fmfi-svt-deadlock/reader-hw/README.md

# PROJECT MOVED

This repository is now hosted here: https://gitlab.com/project-deadlock/reader/rdr-hw-fluocerite-model0

# reader-hw
Schematic, PCB layout and box for the Reader
