fmfi-svt-deadlock/reader-hw/deadlock-reader.brd

## EAGLE design deadlock-reader.brd (2015-10-26)

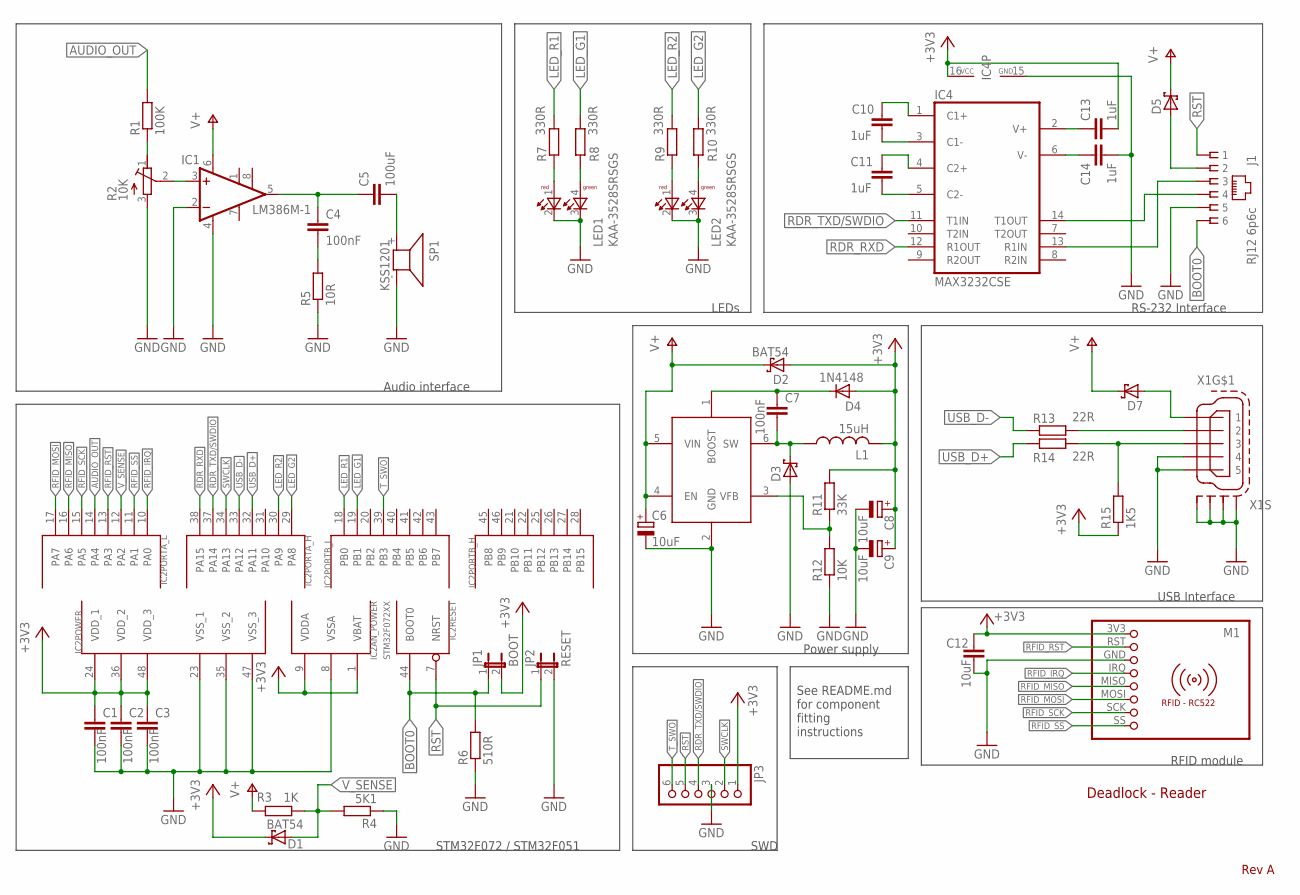
[picture p1: schematic deadlock-reader.sch]

Parts:
C1, C2, C3, C4, C7: 100nF; C0805
C5: 100uF; C1206
C6: 10uF; SMC_D
C8, C9: 10uF; A/3216-18R
C10, C11, C13, C14: 1uF; C0805
C12: 10uF; C0805
D1, D2: BAT54; SOT23
D3, D5, D7: BAT60J; SOD323_ST
D4: 1N4148; SOD323-W
IC1: LM386M-1; SO08
IC2: STM32F072XX; TQFP48
IC3: MCP16301/H; SOT23-6
IC4: MAX3232CSE; SO16
J1: RJ12 6p6c; RJ11-NO_SHIELD
JP1: BOOT; JP1
JP2: RESET; JP1
JP3: PINHD-1X6; 1X06
L1: 15uH; PIS2816
LED1, LED2: KAA-3528SRSGS
M1: RFID-RC522
R1: 100K; M0805
R2: 10K; RTRIM3314G
R3: 1K; R0805
R4: 5K1; R0805
R5: 10R; R0805
R6: 510R; R0805
R7, R8, R9, R10: 330R; R0805
R11: 33K; R0805
R12: 10K; R0805
R13, R14: 22R; R0805
R15: 1K5; R0805
SP1: KSS1201
X1: MINI-USB-SCHIELD-32005-301; 32005-301

Connections:
+3V3: C1.1, C2.1, C3.1, C8.+, C9.+, C12.1, C13.2, D1.3 (C), D2.1 (A), D4.A, IC2.1 (VBAT), IC2.9 (VDDA), IC2.24 (VDD_1), IC2.36 (VDD_2), IC2.48 (VDD_3), IC4.16 (VCC), JP1.2, JP3.1, L1.2, M1.3V3 (1), R11.2, R15.1
AUDIO_OUT: IC2.14 (PA4), R1.2
BOOT0: IC2.44 (BOOT0), J1.6, JP1.1, R6.2
GND: C1.2, C2.2, C3.2, C6.-, C8.-, C9.-, C12.2, C14.2, D3.A, IC1.2 (-IN), IC1.4 (GND), IC2.8 (VSSA), IC2.23 (VSS_1), IC2.35 (VSS_2), IC2.47 (VSS_3), IC3.2 (GND), IC4.15 (GND), J1.5, JP2.2, JP3.3, LED1.2 (C-RED), LED1.3 (C-GREEN), LED2.2 (C-RED), LED2.3 (C-GREEN), M1.GND (3), R2.3 (A), R4.1, R5.1, R6.1, R12.1, SP1.- (2), X1.4, X1.5, X1.M1 (S1), X1.M2 (S2), X1.M3 (S3), X1.M4 (S4)
LED_G1: IC2.19 (PB1), R8.2
LED_G2: IC2.29 (PA8), R10.2
LED_R1: IC2.18 (PB0), R7.2
LED_R2: IC2.30 (PA9), R9.2
unnamed: IC4.13 (R1IN), J1.3
unnamed: IC4.14 (T1OUT), J1.4
unnamed: C10.1, IC4.1 (C1+)
unnamed: C10.2, IC4.3 (C1-)
unnamed: C11.1, IC4.4 (C2+)
unnamed: C11.2, IC4.5 (C2-)
unnamed: C13.1, IC4.2 (V+)
unnamed: C14.1, IC4.6 (V-)
unnamed: D5.A, J1.2
unnamed: LED2.1 (A-RED), R9.1
unnamed: D7.A, X1.1
unnamed: R13.2, X1.2
unnamed: R14.2, R15.2, X1.3
unnamed: R1.1, R2.1 (E)
unnamed: IC1.3 (+IN), R2.2 (S)
unnamed: C4.1, C5.1, IC1.5 (OUT)
unnamed: C4.2, R5.2
unnamed: C5.2, SP1.+ (1)
unnamed: LED1.1 (A-RED), R7.1
unnamed: LED1.4 (A-GREEN), R8.1
unnamed: LED2.4 (A-GREEN), R10.1
unnamed: C7.2, D3.C, IC3.6 (SW), L1.1
unnamed: C7.1, D4.C, IC3.1 (BOOST)
unnamed: IC3.3 (VFB), R11.1, R12.2
RDR_RXD: IC2.38 (PA15), IC4.12 (R1OUT)
RDR_TXD/SWDIO: IC2.37 (PA14), IC4.11 (T1IN), JP3.4
RFID_IRQ: IC2.10 (PA0), M1.IRQ (4)
RFID_MISO: IC2.16 (PA6), M1.MISO (5)
RFID_MOSI: IC2.17 (PA7), M1.MOSI (6)
RFID_RST: IC2.13 (PA3), M1.RST (2)
RFID_SCK: IC2.15 (PA5), M1.SCK (7)
RFID_SS: IC2.11 (PA1), M1.SS (8)
RST: IC2.7 (NRST), J1.1, JP2.1, JP3.5
SWCLK: IC2.34 (PA13), JP3.2
T_SWO: IC2.39 (PB3), JP3.6
USB_D+: IC2.32 (PA11), R14.1
USB_D-: IC2.33 (PA12), R13.1
V+: C6.+, D2.3 (C), D5.C, D7.C, IC1.6 (VS), IC3.4 (EN), IC3.5 (VIN), R3.2
V_SENSE: D1.1 (A), IC2.12 (PA2), R3.1, R4.2

Notes on the sheet:
Deadlock - Reader
Rev A
RS-232 Interface
USB Interface
Audio interface
LEDs
STM32F072 / STM32F051
RFID module
SWD
Power supply
See README.md for component fitting instructions

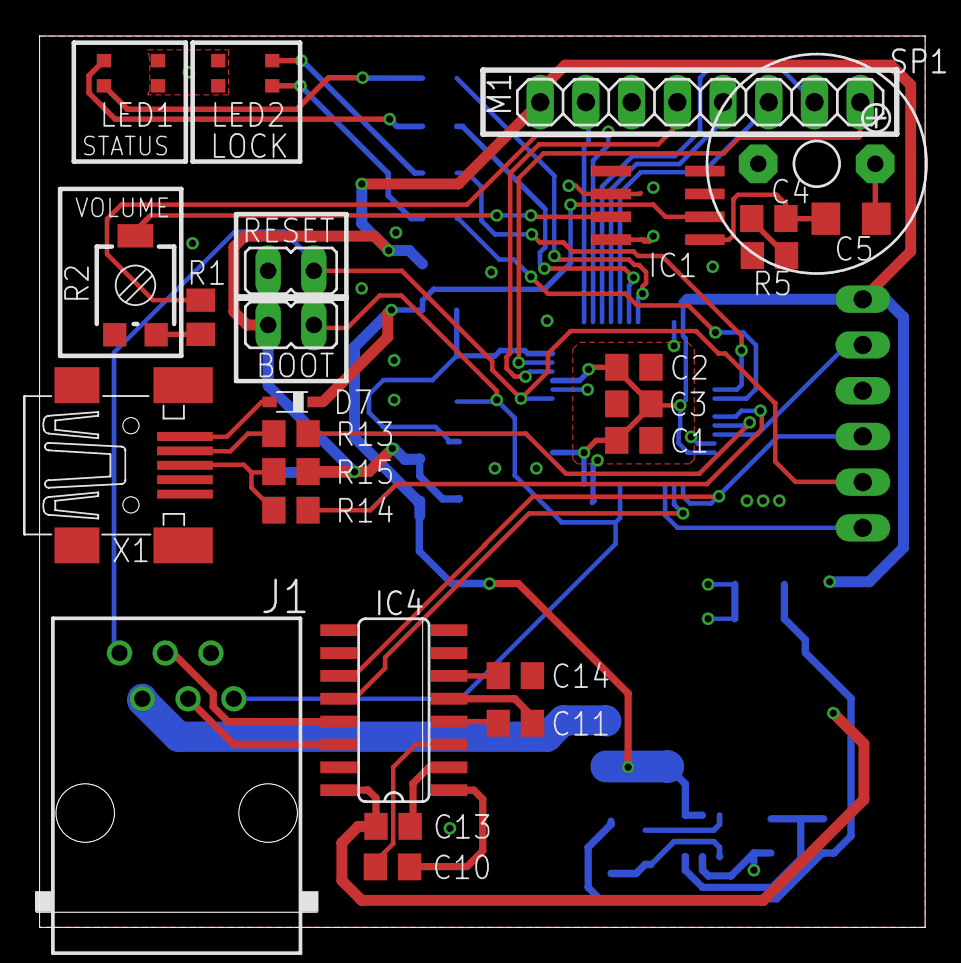
[picture p2: board deadlock-reader.brd from above]

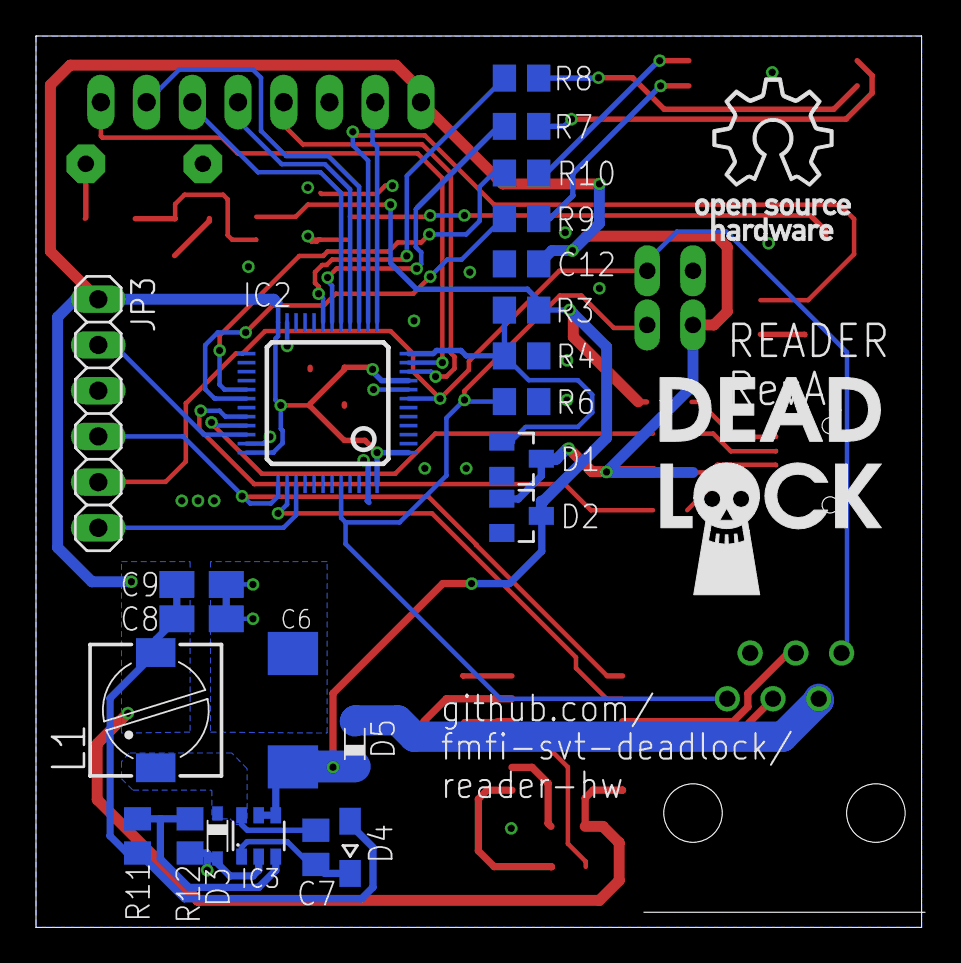
[picture p3: board deadlock-reader.brd from below]

Board: 2 copper layers, 49.2 x 49.5 mm, 49 parts (23 on the bottom side), 47 nets.
