fmfi-svt-deadlock/reader-hw/docs/build-requirements.txt

Sphinx
recommonmark
sphinx-autobuild
sphinx_rtd_theme
