fmfi-svt-deadlock/reader-hw/(threads)

Thread 1 (2015-12-18):

D1 and D2 should be BAT54A

adam-dej, 2015-12-18:
They are BAT54 in current design => swapped pins and causing short circuit

Thread 2 (2015-12-18):

SWCLK and SWDIO is swapped on the SWD connector

adam-dej, 2015-12-18:
TODO: Should this be fixed or should the debug connector be removed from the production version?

Thread 4 (2016-11-11):

Ground plane under MCU can get easily isolated

adam-dej, 2016-11-11:
Ground plane (bottom and top) around the CPU can get easily isolated if trace under pad 47 of the MCU gets damaged.

This ground plane should be connected to ground on more places.
