fmfi-svt-deadlock/reader-hw/(commit log)

2015-03-19 Add empty schematic
    [gate.sch]
2015-03-27 Add RS-232 interface
    [gate.sch]
2015-03-27 Add audio output
    [gate.sch]
2015-03-29 Minor mid-review fixes
    [gate.sch]
2015-03-29 Add LEDs
    [gate.sch]
2015-03-29 Add volume resistor ladder for audio output
    [gate.sch]
2015-03-29 Add STM32F0[72|51] MCU
    [gate.sch]
2015-03-29 Add RFID module
    [gate.sch]
2015-03-29 Add SWD header
    [gate.sch]
2015-03-30 Add power supply
    [gate.sch]
2015-03-30 Finishing touches for revA
    [gate.sch]
2015-03-30 Minor value tweaks
    [gate.sch]
2015-03-30 Review-induced fixes
    [gate.sch]
2015-07-05 Remove all occurences of name 'Gate'
    [deadlock-reader.sch]
2015-07-21 User trimmer to regulate audio volume instead of digital pot
    [deadlock-reader.sch]
2015-07-25 Select components from distributor and adjust footprints
    [deadlock-reader.sch]
2015-08-06 Draft component placements
    [deadlock-reader.brd]
2015-08-06 Optimize component placements
    [deadlock-reader.brd]
2015-10-21 Final component placement
    [deadlock-reader.brd, deadlock-reader.sch]
2015-10-21 [WIP] Route the power converter
    [deadlock-reader.brd]
2015-10-21 [WIP] Fix DRC errors on power converter layout
    [deadlock-reader.brd]
2015-10-21 [WIP] Route debug and RFID connectors to the MCU
    [deadlock-reader.brd]
2015-10-21 [WIP] Route leds and audio interface
    [deadlock-reader.brd]
2015-10-21 [WIP] Route RS-232 and USB interfaces
    [deadlock-reader.brd]
2015-10-22 [WIP] Route misc remaining signal lines
    [deadlock-reader.brd]
2015-10-22 [WIP] Route power distribution network
    [deadlock-reader.brd]
2015-10-22 Create ground planes, board routing finished
    [deadlock-reader.brd]
2015-10-23 Incorporate revA board review fixes
    [deadlock-reader.brd, deadlock-reader.sch]
2015-10-23 Reorganize component labels on the silkscreen
    [deadlock-reader.brd, deadlock-reader.sch]
2015-10-23 Add logos to the silkscreen
    [deadlock-reader.brd]
2015-10-26 Fix silkscreen logos; now they are exportable
    [deadlock-reader.brd]
2015-10-26 Enlarge repo address on silkscreen
    [deadlock-reader.brd]
2015-10-26 Add exported gerber files for revA
    [deadlock-reader.GBL, deadlock-reader.GBO, deadlock-reader.GBP, deadlock-reader.GBS, deadlock-reader.GTL, deadlock-reader.GTO, deadlock-reader.GTP, deadlock-reader.GTS]
